dtomyn/RingCameraWedge/Scan_20261101.png

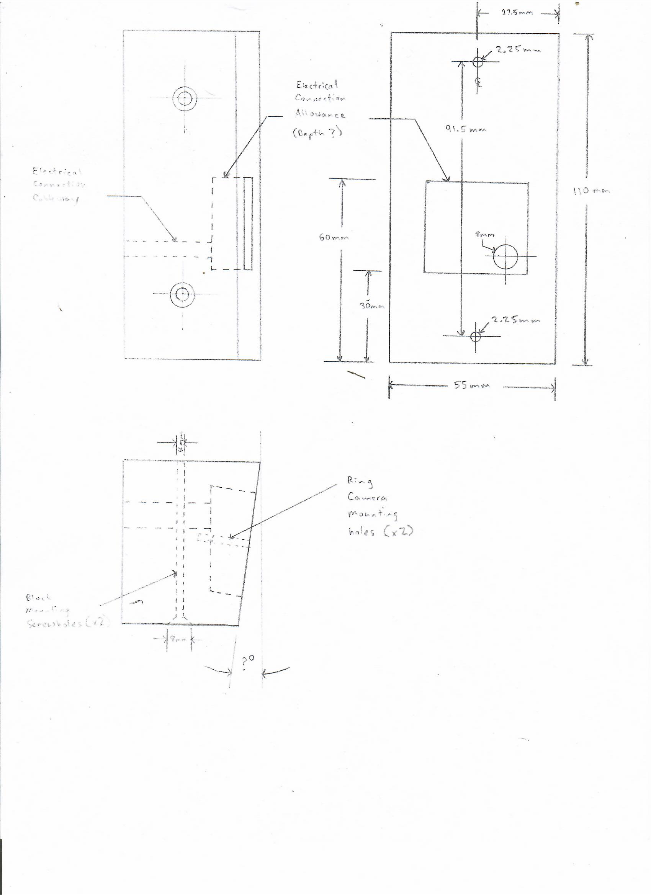
Scan_20261101.png
