dtomyn/RingCameraWedge/ring_camera_wedge_adjustable_assembly.stl

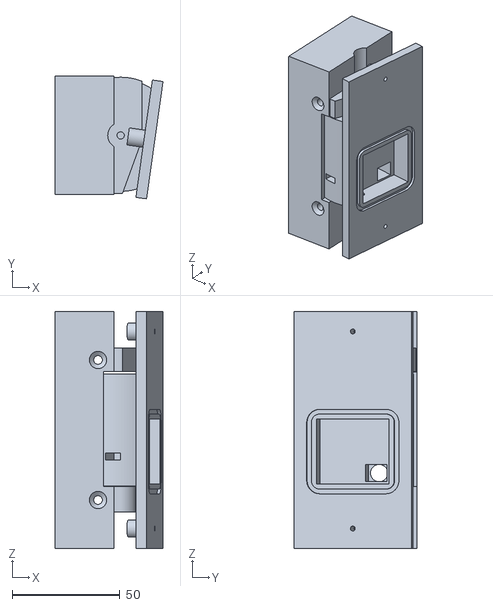
[picture p4: CAD file, 2026-11-01]
ring_camera_wedge_adjustable_assembly.stl
50.2 x 57.0 x 110.0
