dtomyn/RingCameraWedge/ring_camera_wedge.stl

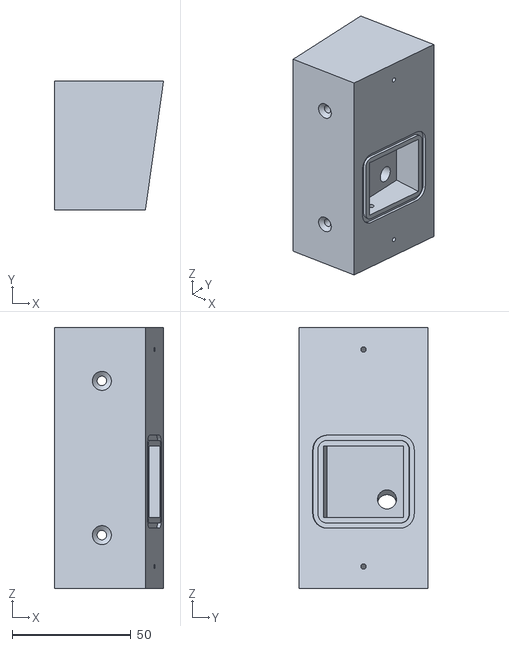
[picture p5: CAD file, 2026-11-01]
ring_camera_wedge.stl
46.0 x 54.5 x 110.0
