dtomyn/RingCameraWedge/ring_camera_wedge_adjustable_base.stl

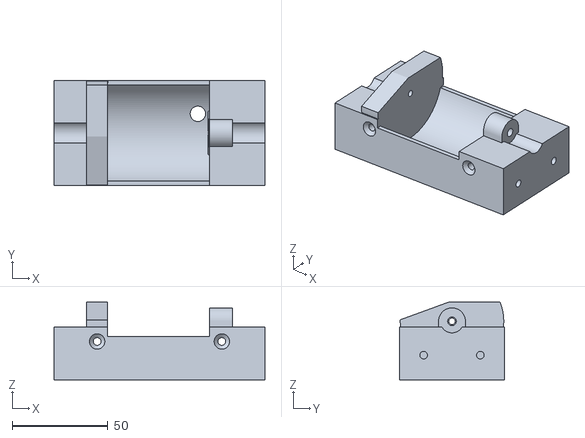
[picture p6: CAD file, 2026-11-01]
ring_camera_wedge_adjustable_base.stl
110.0 x 55.0 x 40.5
