dtomyn/RingCameraWedge/ring_camera_wedge_adjustable_head.stl

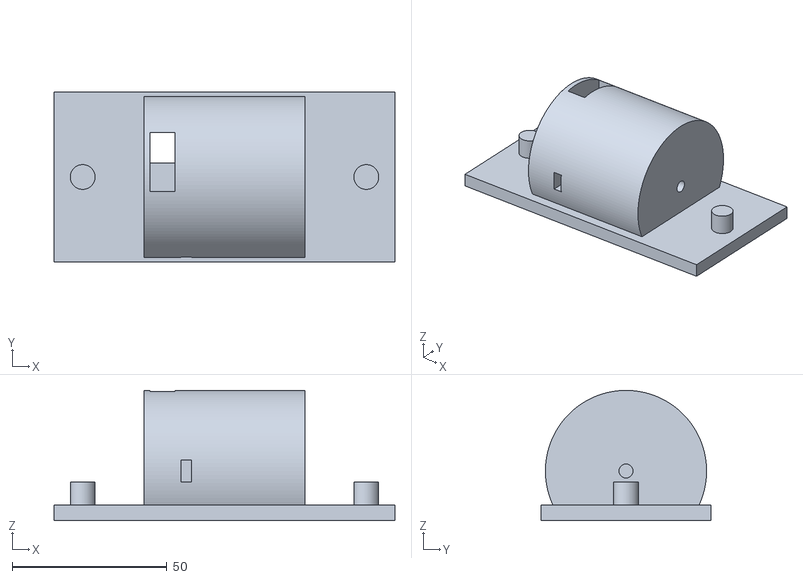
[picture p7: CAD file, 2026-11-01]
ring_camera_wedge_adjustable_head.stl
110.0 x 55.0 x 42.0
