dtomyn/RingCameraWedge/(commit log)

2026-11-01 Add Ring camera wedge model and generator
    Parametric Python script that builds the angled mounting block from the
    hand sketch and exports an STL for Tinkercad. Includes setup instructions
    for a virtual environment and a VS Code dev container.
    [ring_camera_wedge.stl]
2026-11-01 Add adjustable-angle version of the wedge
    The camera angle at the installation is not yet known, so add a two-part
    design: a fixed base and a head that swivels on a vertical axis from 0 to
    20 degrees, clamped by two M4 screws reachable with the camera fitted.
    [ring_camera_wedge_adjustable_assembly.stl, ring_camera_wedge_adjustable_base.stl, ring_camera_wedge_adjustable_head.stl]
2026-11-01 Lock the adjustable wedge with interlocking teeth
    Friction alone could relax over time in printed plastic. Add radial teeth
    between the head and the lower cheek, giving 4 degree steps from 0 to 20.
    The lower screw now clamps the teeth together, and the upper screw is a
    pivot only, so the head can lift to clear the teeth when adjusting.
    Document the locking and adjustment in the README.
    [ring_camera_wedge_adjustable_assembly.stl, ring_camera_wedge_adjustable_base.stl, ring_camera_wedge_adjustable_head.stl]
2026-11-01 fixed flaw
    [ring_camera_wedge.stl]
